TakoyakiFuwa/stm32_camera/(list of files, drawings)

Other design files:
EDA/Camera.eprj
