TakoyakiFuwa/stm32_camera/CODE/tft/TFT_ST7789V.h

#ifndef __TFT_ST7789V_H__
#define __TFT_ST7789V_H__
#include <stdint.h>

//工具函数
uint16_t TFT_RGB888To565(uint32_t RGB_888);
//通信
void TFT_SPI_Start(void);
void TFT_SPI_Stop(void);
void TFT_SPI_Send(uint8_t byte);
//DMA传输
void TFT_DMA_Send(uint16_t counts);
void TFT_DMA_SetAddr(uint8_t* addr);
//主要的接口
void Init_TFT(uint8_t* data_addr);
void TFT_SetCursor(uint16_t x,uint16_t y,uint16_t width,uint16_t height);
void TFT_Write16Data(uint16_t RGB_565);
void TFT_SetRotation(uint8_t rotation);

#endif
