TakoyakiFuwa/stm32_camera/(commit log)

2025-09-13 添加屏幕驱动
    [f4_ui.eprj]
2025-09-13 相机简单测试
2025-09-14 实现相机软件驱动
2025-09-14 添加ILI9341测试
2025-09-15 添加SPI硬件驱动，修改ST7735接口
2025-09-15 DMA驱动SPI,相片修改为全局变量存储
2025-09-15 PB8->PB7 小型硬件故障
2025-09-17 DCMI软件驱动
2025-09-17 可以在f4_ui板子上使用摄像头配合st7735输出
2025-09-21 软排线摄像头测试
    [f4_ui.eprj]
2025-09-26 软件驱动
    [f4_ui.eprj]
2025-09-26 硬件驱动(摄像头和屏幕，含DMA)
2025-10-02 相机板子上做了适配(300*200输出)
2025-10-03 全硬件测试
2025-10-06 添加bmp.h/c
2025-10-11 bmp.h/c添加快速读写内容
2025-10-13 添加宏文件/基本功能实现
2025-10-14 添加UI显示底层
2025-10-14 添加UI框架
2025-10-27 UI完成侧边栏
2025-10-27 开机加载界面完成
2025-10-28 界面更加完善，补充SD卡内容
2025-10-28 基础功能实现
2025-10-29 实现删除图片
2025-10-31 初步结项，代码混乱，缺乏UI
2025-11-14 整理文件结构
    [Camera.eprj, f4_ui.eprj]
2025-11-21 更改为stm32f429主频
